gokulg3107-sudo/CPU-Lite-/src_with_sram/src/tb_cpu_lite_v2.v

`include "header_file.h"
// Runs whatever is in program_memory.hex until HALT, dumps registers and checks them.
module tb_cpu_lite_hex;
parameter real CPU_HALF = 3.333, MEM_HALF = 7.143;
parameter integer TIMEOUT = 2000000;
reg clk_cpu, clk_mem, rst;
cpu_lite dut(.clk_cpu(clk_cpu), .clk_mem(clk_mem), .rst(rst));
initial clk_cpu = 1'b0;
initial clk_mem = 1'b0;
always #CPU_HALF clk_cpu = ~clk_cpu;
always #MEM_HALF clk_mem = ~clk_mem;
integer cycles, i, pass_count, fail_count;
reg [31:0] exp [0:15];

//The SAED SRAM macros have no reset, so zero every bit of every bank at time 0
//(32 banks x 32 one-bit slices x 512 words), same as the old behavioural data_memory reset
initial begin : preload_sram
    integer k;
    for (k = 0; k < 512; k = k + 1) begin
        dut.memory_module.mem_chain.mem.sram0.sram_IO0.memory[k] = 1'b0;
        dut.memory_module.mem_chain.mem.sram0.sram_IO1.memory[k] = 1'b0;
        dut.memory_module.mem_chain.mem.sram0.sram_IO2.memory[k] = 1'b0;
        dut.memory_module.mem_chain.mem.sram0.sram_IO3.memory[k] = 1'b0;
        dut.memory_module.mem_chain.mem.sram0.sram_IO4.memory[k] = 1'b0;
        dut.memory_module.mem_chain.mem.sram0.sram_IO5.memory[k] = 1'b0;
        dut.memory_module.mem_chain.mem.sram0.sram_IO6.memory[k] = 1'b0;
        dut.memory_module.mem_chain.mem.sram0.sram_IO7.memory[k] = 1'b0;
        dut.memory_module.mem_chain.mem.sram0.sram_IO8.memory[k] = 1'b0;
        dut.memory_module.mem_chain.mem.sram0.sram_IO9.memory[k] = 1'b0;
        dut.memory_module.mem_chain.mem.sram0.sram_IO10.memory[k] = 1'b0;
        dut.memory_module.mem_chain.mem.sram0.sram_IO11.memory[k] = 1'b0;
        dut.memory_module.mem_chain.mem.sram0.sram_IO12.memory[k] = 1'b0;
        dut.memory_module.mem_chain.mem.sram0.sram_IO13.memory[k] = 1'b0;
        dut.memory_module.mem_chain.mem.sram0.sram_IO14.memory[k] = 1'b0;
        dut.memory_module.mem_chain.mem.sram0.sram_IO15.memory[k] = 1'b0;
        dut.memory_module.mem_chain.mem.sram0.sram_IO16.memory[k] = 1'b0;
        dut.memory_module.mem_chain.mem.sram0.sram_IO17.memory[k] = 1'b0;
        dut.memory_module.mem_chain.mem.sram0.sram_IO18.memory[k] = 1'b0;
        dut.memory_module.mem_chain.mem.sram0.sram_IO19.memory[k] = 1'b0;
        dut.memory_module.mem_chain.mem.sram0.sram_IO20.memory[k] = 1'b0;
        dut.memory_module.mem_chain.mem.sram0.sram_IO21.memory[k] = 1'b0;
        dut.memory_module.mem_chain.mem.sram0.sram_IO22.memory[k] = 1'b0;
        dut.memory_module.mem_chain.mem.sram0.sram_IO23.memory[k] = 1'b0;
        dut.memory_module.mem_chain.mem.sram0.sram_IO24.memory[k] = 1'b0;
        dut.memory_module.mem_chain.mem.sram0.sram_IO25.memory[k] = 1'b0;
        dut.memory_module.mem_chain.mem.sram0.sram_IO26.memory[k] = 1'b0;
        dut.memory_module.mem_chain.mem.sram0.sram_IO27.memory[k] = 1'b0;
        dut.memory_module.mem_chain.mem.sram0.sram_IO28.memory[k] = 1'b0;
        dut.memory_module.mem_chain.mem.sram0.sram_IO29.memory[k] = 1'b0;
        dut.memory_module.mem_chain.mem.sram0.sram_IO30.memory[k] = 1'b0;
        dut.memory_module.mem_chain.mem.sram0.sram_IO31.memory[k] = 1'b0;
        dut.memory_module.mem_chain.mem.sram1.sram_IO0.memory[k] = 1'b0;
        dut.memory_module.mem_chain.mem.sram1.sram_IO1.memory[k] = 1'b0;
        dut.memory_module.mem_chain.mem.sram1.sram_IO2.memory[k] = 1'b0;
        dut.memory_module.mem_chain.mem.sram1.sram_IO3.memory[k] = 1'b0;
        dut.memory_module.mem_chain.mem.sram1.sram_IO4.memory[k] = 1'b0;
        dut.memory_module.mem_chain.mem.sram1.sram_IO5.memory[k] = 1'b0;
        dut.memory_module.mem_chain.mem.sram1.sram_IO6.memory[k] = 1'b0;
        dut.memory_module.mem_chain.mem.sram1.sram_IO7.memory[k] = 1'b0;
        dut.memory_module.mem_chain.mem.sram1.sram_IO8.memory[k] = 1'b0;
        dut.memory_module.mem_chain.mem.sram1.sram_IO9.memory[k] = 1'b0;
        dut.memory_module.mem_chain.mem.sram1.sram_IO10.memory[k] = 1'b0;
        dut.memory_module.mem_chain.mem.sram1.sram_IO11.memory[k] = 1'b0;
        dut.memory_module.mem_chain.mem.sram1.sram_IO12.memory[k] = 1'b0;
        dut.memory_module.mem_chain.mem.sram1.sram_IO13.memory[k] = 1'b0;
        dut.memory_module.mem_chain.mem.sram1.sram_IO14.memory[k] = 1'b0;
        dut.memory_module.mem_chain.mem.sram1.sram_IO15.memory[k] = 1'b0;
        dut.memory_module.mem_chain.mem.sram1.sram_IO16.memory[k] = 1'b0;
        dut.memory_module.mem_chain.mem.sram1.sram_IO17.memory[k] = 1'b0;
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
        dut.memory_module.mem_chain.mem.sram31.sram_IO29.memory[k] = 1'b0;
        dut.memory_module.mem_chain.mem.sram31.sram_IO30.memory[k] = 1'b0;
        dut.memory_module.mem_chain.mem.sram31.sram_IO31.memory[k] = 1'b0;
    end
end

initial begin
    pass_count = 0; fail_count = 0;
    exp[0]=32'h00004100; exp[1]=32'h00000140; exp[2]=32'h00000000; exp[3]=32'h0000033F;
    exp[4]=32'h000000BF; exp[5]=32'h00001820; exp[6]=32'h00000D94; exp[7]=32'h00000D94;
    exp[8]=32'h000017E0; exp[9]=32'h00002920; exp[10]=32'h000017E0; exp[11]=32'h000002D0;
    exp[12]=32'h043FE482; exp[13]=32'h0000000D; exp[14]=32'h00003FFF; exp[15]=32'h000000BF;
    rst = 1'b0; #50 rst = 1'b1;
    cycles = 0;
    while (dut.cpu.halted !== 1'b1 && cycles < TIMEOUT) begin @(posedge clk_cpu); cycles = cycles + 1; end
    if (dut.cpu.halted !== 1'b1) $display("[FAIL] no HALT within %0d cycles (pc=%0d)", TIMEOUT, dut.cpu.pc);
    else $display("HALT after %0d cycles", cycles);
    repeat (20) @(posedge clk_cpu); #1;
    for (i = 0; i < 16; i = i + 1) begin
        if (dut.cpu.general_purpose_register[i] === exp[i]) begin pass_count = pass_count + 1; $display("[PASS] R%0d = 0x%h", i, exp[i]); end
        else begin fail_count = fail_count + 1; $display("[FAIL] R%0d = 0x%h, expected 0x%h", i, dut.cpu.general_purpose_register[i], exp[i]); end
    end
    $display("TOTAL: %0d  PASS: %0d  FAIL: %0d", pass_count+fail_count, pass_count, fail_count);
    $finish;
end
endmodule
