gokulg3107-sudo/CPU-Lite-/src_with_sram/src/rtl/cpu_cache_interface.v

`include "header_file.h"
module cpu_cache_interface(clk_cpu, rst, start, cache_done, control_signals, cache_data_out, cpu_addr, data_bus_in, data_bus_out, lookup_addr, cpu_data_in, line_bus_in, line_bus_out, cpu_done, cache_start);
input clk_cpu, rst, start, cache_done;
input [1:0] control_signals;
input [13:0] cpu_addr;
input [31:0] data_bus_in;
output [31:0] data_bus_out;
output reg [13:0] lookup_addr;
output [31:0] cpu_data_in;
input [511:0] line_bus_in;
output [511:0] line_bus_out;
input [31:0] cache_data_out;
output cpu_done;
output reg cache_start;

localparam [2:0] idle = 3'd0, single_word = 3'd1, fill_line = 3'd2, stack_control_signal = 3'd3, done = 3'd4;
reg [2:0] current_state, next_state;
reg [511:0] line_buf;

always@(posedge clk_cpu or negedge rst) begin
        if(~rst) current_state <= idle;
        else current_state <= next_state;
end

//Latch the CPU address on start so lookup_addr stays stable for the whole
//transaction (l1_cache and cache_memory_interface both use it).
always@(posedge clk_cpu or negedge rst) begin
        if(~rst) lookup_addr <= 14'd0;
        else if(current_state == idle & start) lookup_addr <= cpu_addr;
end

reg [3:0] count_word_collect;
always@(posedge clk_cpu or negedge rst) begin
        if(~rst) count_word_collect <= 4'd0;
        else if(current_state == fill_line | (current_state == done & control_signals == `stack_retrieve)) count_word_collect <= count_word_collect + 1'b1;
        else count_word_collect <= 4'd0;
end
always@(*) begin
        case(current_state)
        idle: begin
                if(start) begin
                        if(control_signals == `load_data | control_signals == `store_data) next_state = single_word;
                        else if(control_signals == `store_stack) next_state = fill_line;
                        else next_state = stack_control_signal;
                end
                else next_state = idle;
        end
        single_word: next_state = cache_done ? done : single_word;
        fill_line: next_state = count_word_collect == 4'd15 ? stack_control_signal : fill_line;
        stack_control_signal: next_state = cache_done ? done : stack_control_signal;
        done: begin
                if(control_signals != `stack_retrieve) next_state = idle;
                else next_state = (count_word_collect == 4'd15) ? idle : done;
        end
        default: next_state = idle;
        endcase
end

//Line buffer. store_stack: 16 CPU words are shifted in (first word ends up in
//[31:0]). stack_retrieve: line is captured from line_bus_in when the cache is done,
//then shifted out 32 bits per cycle starting from [31:0], same order as stored.
always@(posedge clk_cpu or negedge rst) begin
        if(~rst) line_buf <= 512'd0;
        else if(current_state == fill_line) line_buf <= {data_bus_in, line_buf[511:32]};
        else if(current_state == stack_control_signal & control_signals == `stack_retrieve & cache_done) line_buf <= line_bus_in;
        else if(current_state == done & control_signals == `stack_retrieve) line_buf <= {32'd0, line_buf[511:32]};
end

//Line goes out to the cache only while pushing a stored stack line; 0 otherwise.
assign line_bus_out = (current_state == stack_control_signal & control_signals == `store_stack) ? line_buf : 512'd0;

//CPU read data is presented only in done: load returns the cache word,
//stack_retrieve streams the line. 0 otherwise. Valid while cpu_done is high.
assign data_bus_out = (current_state == done & control_signals == `load_data) ? cache_data_out : (current_state == done & control_signals == `stack_retrieve) ? line_buf[31:0] : 32'd0;

//Store word goes to the cache from the CPU write bus; held by the CPU until cache_done.
assign cpu_data_in = (current_state == single_word) ? data_bus_in : 32'd0;

assign cpu_done = current_state == done;
always@(*) begin
	case(current_state)
		idle, done, fill_line: cache_start = 1'b0;
		single_word, stack_control_signal: cache_start = 1'b1;
	default: cache_start = 1'b0;
endcase
end
endmodule
