gokulg3107-sudo/CPU-Lite-/src_including_sram/src/rtl/reset_synchronizer.v

module reset_synchronizer(clk, rst, reset_in, rst_sync);
input clk, rst, reset_in;
output rst_sync;
reg sync1, sync2;
always@(posedge clk or negedge rst) begin
	if(~rst) begin
	 	sync1 <= 1'b0;
		sync2 <= 1'b0;
	end
	else begin
		sync1 <= reset_in;
		sync2 <= sync1;
	end
end
assign rst_sync = sync2;
endmodule
