gokulg3107-sudo/CPU-Lite-/memory_chain/header_file.h

`define valid_bit 4'd15
`define dirty_bit 4'd14
`define tag_bits 14:9   
`define offset_bits 3:0
`define load_data 2'b00
`define store_data 2'b01
`define store_stack 2'b10
`define stack_retrieve 2'b11
