gokulg3107-sudo/CPU-Lite-/(commit log)

2026-09-19 Memory Chain Initial test
2026-09-22 Memory Chain works
2026-10-08 replaced behavioral RTL with SRAM Cells
    [async_fifo.v, cache_memory_interface.v, cpu_cache_interface.v, cpu_core.v, cpu_lite.v, data_memory.v, l1_cache.v, memory_interface.v]
2026-10-12 Create sample
